AlexanderAni/polivator/pdf/PCB_Connector-Type1.2A_A4.pdf

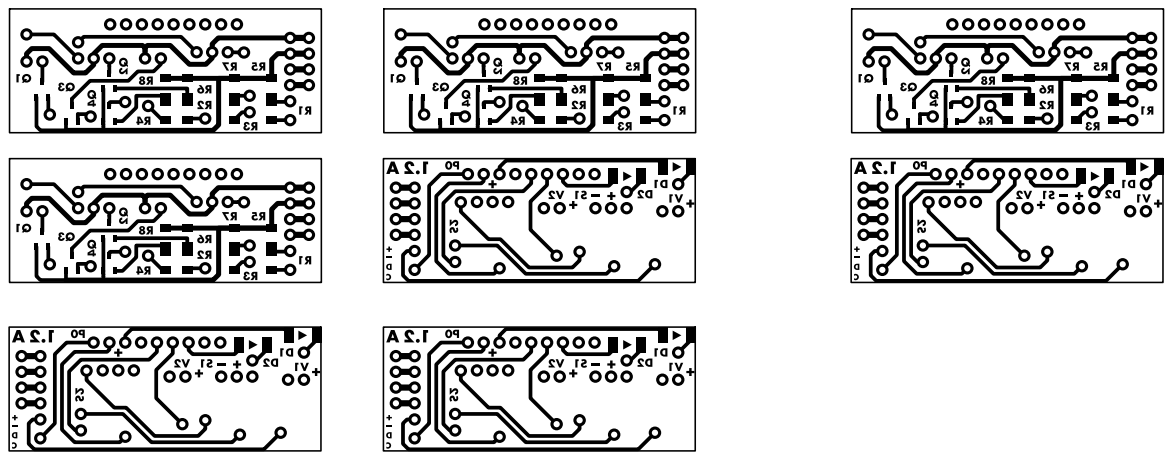
[picture p1: page 1]
