AlexanderAni/polivator/pdf/PCB_Connector-Type1.2A_bottom.pdf

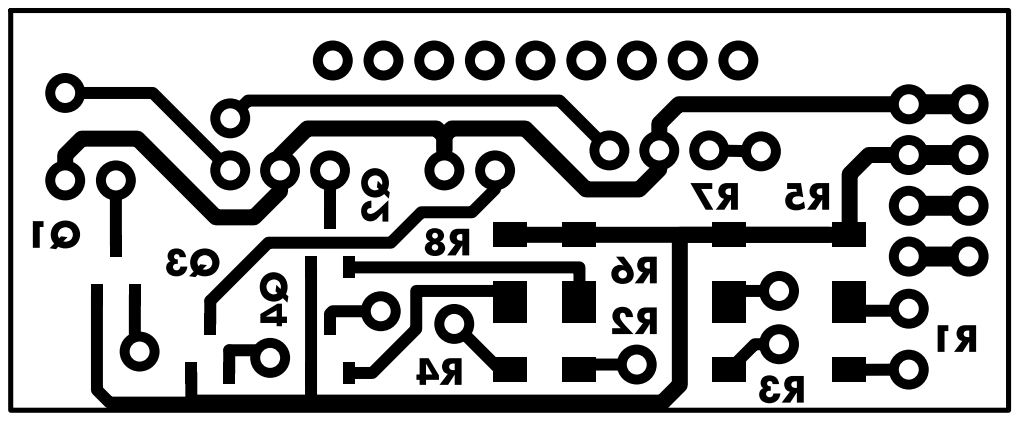
[picture p2: page 1]
