AlexanderAni/polivator/pdf/PCB_Connector-Type1.2A_circuit.pdf

H2 1 1 2 2 3 3 4 4 5 5 6 6 7 7 8 8 9 9

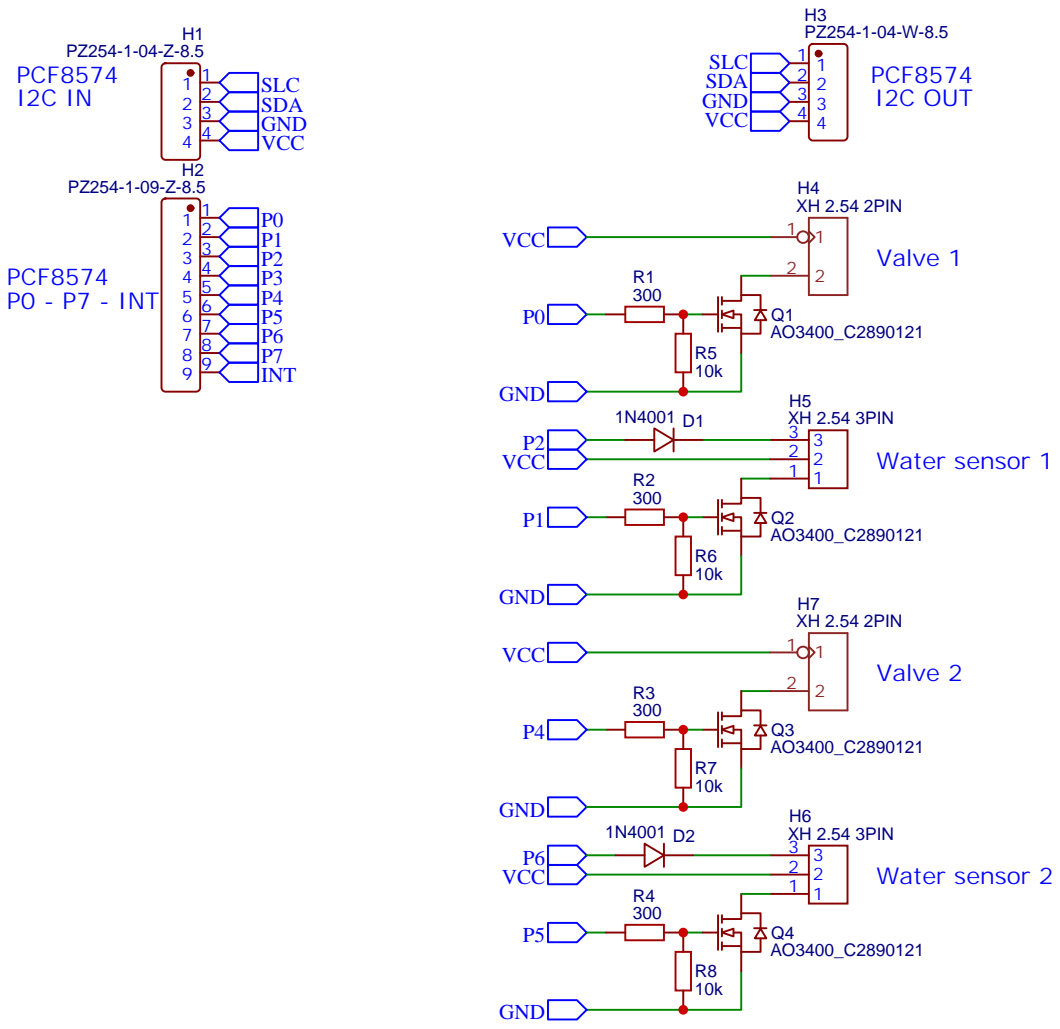
[picture p3: page 1]
