AlexanderAni/polivator/pdf/PCB_Connector-Type1.2A_top.pdf

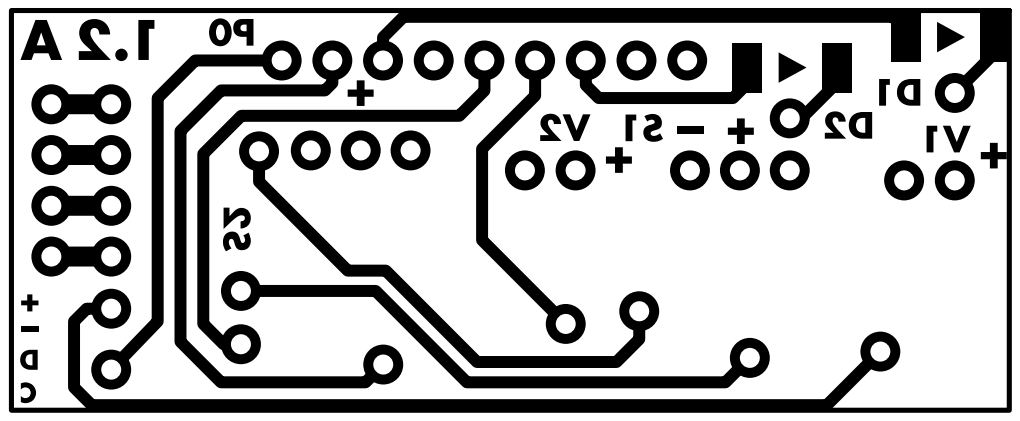
[picture p4: page 1]
