AlexanderAni/polivator/(commit log)

2022-04-20 MOD flower humidity moved to state
2022-04-20 FIX wake up by button
    [encoder.ino]
2022-04-21 FIX 5v analog input reference for sensors (Arduino Pro Mini)
    [setup.ino]
2022-04-22 MOD soil sensor pins
2022-04-22 ADD soil sensor select
2022-04-22 FIX soil number selection
    [display.ino, menu.ino]
2022-04-22 FIX display stretched width (LR)
    [display.ino]
2022-04-25 ADD water level sensor
2022-04-25 FIX encoder interrupts
2022-04-25 FIX changed data saving
    [memory.ino, menu.ino, setup.ino, sleep.ino, structure.h]
2022-04-25 ADD leakage finish delay settings
    [config.h, display.ino, menu.ino, polivator.ino, setup.ino, structure.h]
2022-04-26 FIX leakage by interrupt, leakage time value
    [display.ino, menu.ino, polivator.ino, setup.ino]
2022-04-26 DEL soil sensors. ADD flower humid limit, water humid and temp
2022-04-26 MOD encoder interrupt by turn
2022-04-27 ADD pump speed settings, speed check
2022-04-27 ADD Flower Water Sensors
2022-04-29 FIX full-of-water forever cycle. ADD water errors
    [config.h, display.ino, menu.ino, polivator.ino, setup.ino, structure.h]
2022-05-05 ADD Connector TypeA PCB
2022-05-19 MOD connector address
2022-05-19 FIX flower parameter name
    [display.ino]
2022-05-19 ADD hot dry flower period
2022-05-19 FIX MAJOR VERSION SIZE
    [config.h, display.ino]
2022-05-19 MOD memory optimization: up to 6 flowers
2022-05-21 UPD PCB
2022-05-26 MOD 100ml test
2022-05-26 ADD i2c display
2022-05-27 ADD 8 flowers, 4 connectors
